rwrife/pinpath/hardware/README.md

# Hardware plan

## System block description

```text
USB 5 V SELV
    |
[power/protection] -> [RP2040 module + USB CDC]
                            |
                  [protected scan front end]
                     /                \
             [16-pin Bank A]      [16-pin Bank B]
                     |                  |
              passive adapter     passive adapter
                       \              /
                    de-energized cable
```

The rev-A schematic uses Raspberry Pi Pico `SC0915`, eight TI `TMUX1108PWR` muxes for independent stimulus/sense paths, 10 kΩ endpoint current limiting, low-leakage rail clamps, four-channel ESD arrays, and a two-phase 0/1.8 V precheck bias. The editable project is now in `pinpath.kicad_pro` / `pinpath.kicad_sch`; exact references, packages, manufacturer properties, GPIO allocation, and pinout evidence are in [the component-selection handoff](selection/component-selection.md) and [schematic pinout evidence](schematic-pinout-evidence.md). Native KiCad 9 ERC is clean, but this remains static EDA evidence only: `selection/limits-rev-a.json` is still `validated: false`, so no scan is authorized before layout review and bench characterization. Normative behavior and evidence gates remain in [requirements](requirements.md), [architecture](../docs/architecture.md), [risk analysis](../docs/risk-analysis.md), and the [verification matrix](../docs/verification-matrix.md).

## Interfaces

- USB CDC for power, configuration, and reports
- Two keyed 16-position low-voltage test-bank connectors
- Replaceable passive adapters; first targets are numbered headers and labeled flying leads
- SWD or vendor-supported debug connection and a documented recovery path
- Physical start/cancel control and text/shape-capable or coded status indication

## Power plan

USB 5 V SELV enters only through the Pico micro-USB connector; its on-module supply generates 3V3 for the candidate front end. The two-phase precheck requires all 32 endpoints to track both a low bias and the measured 1.8 V reference while every stimulus enable is low. Provisional thresholds and calculated fault currents are recorded in `selection/limits-rev-a.json`, but are explicitly unvalidated and cannot authorize firmware scanning. The design must not source meaningful operating power into the item under test.

## Enclosure and assembly concept

A small screw-fastened or snap-fit printed enclosure will expose the two adapter sockets, USB, button, and status window. The PCB will use hand-assembly-friendly parts where practical, mounting holes, clear pin numbering, probeable test points, and replaceable adapters so connector wear does not require replacing the main board.

## Safety limits

Use only with fully disconnected, de-energized passive cables and harnesses. Never attach mains, PoE, powered USB through a test bank, a battery or battery pack, vehicles, medical or life-safety wiring, or any energized circuit. PinPath makes no cable certification claim and is not a hipot tester, insulation tester, precision ohmmeter, or protective instrument. Protection circuitry cannot make prohibited live testing safe.

## Editable KiCad deliverables

Current schematic-stage sources and evidence are:

- `hardware/pinpath.kicad_pro`
- `hardware/pinpath.kicad_sch`
- `hardware/pinpath.kicad_pcb` (rev-A carrier layout candidate; see [PCB layout evidence](PCB-layout-evidence.md) for DRC status, residuals, and fab-candidate posture)
- `hardware/pinpath.kicad_sym`
- `hardware/pinpath.pretty/RaspberryPi_Pico_SMD_HandSolder.kicad_mod`
- `hardware/TestPoint.pretty/` (project-local micro test points)
- `hardware/schematic-pinout-evidence.md`
- `hardware/PCB-layout-evidence.md`
- `hardware/reports/pinpath-erc.rpt`
- `hardware/reports/drc-20260918-final.json` (0 errors; adjudicated warnings)
- `hardware/reports/pinpath-schematic.pdf` (review supplement, not source)
- `hardware/fab-out/pinpath-gerbers/` + `fab-out/gerber-inspection.json` (inspected release-candidate fabrication outputs)
- `hardware/adapters/known-loopback/` (passive one-to-one electrical fixture definition)
- `bom/bom.csv` (native export from schematic properties)
- `bom/non-schematic-items.csv`

The carrier PCB now exists as a layout candidate with 0-error native DRC;
the single remaining stub, pour-island residual, and adapter cable-assembly
decision are adjudicated in [PCB layout evidence](PCB-layout-evidence.md).
Final Manufacturer/MPN/source data lives in schematic symbol properties and
exports to tracked `bom/bom.csv`; volatile costs remain explicitly `UNKNOWN`
until dated supplier evidence is obtained.

## Issue #7 integration artifacts (2026-09-19)

- `reports/erc-20260919-release.rpt` — native ERC re-run on committed
  schematic: 0 errors / 0 warnings.
- `reports/drc-20260919-release.json` — native DRC re-run including
  schematic-parity: 0 errors, 63 warnings, 66 ratsnest items — identical to
  the 2026-09-18 candidate state; the 4 parity entries are the off-schematic
  mounting holes (intentional, see layout evidence item 4).
- `reports/pinpath-schematic-20260919-release.pdf` — review PDF re-export.
- `reports/integration-scenario-matrix-hostsim.json` — 13-scenario
  integration matrix executed by `firmware/tests/test_scenarios.cpp`;
  `host_simulation` evidence only, not bench evidence.
- `fab-out/renders/` — native `kicad-cli pcb render` top/bottom renders of
  the unpopulated candidate.
- Assembly guide, bring-up checklist, and characterization plan live in
  `../docs/`; the release gate is `../release/RELEASE-READINESS.md`.
