rwrife/pinpath/release/RELEASE-READINESS.md

# PinPath rev-A candidate — release readiness checklist and manifest status

Status: **release NOT tagged and MUST NOT be tagged yet.** This issue's own
acceptance line — "tag a release only when evidence supports it" — is not met,
because the bench evidence gate is open: no unit has been fabricated or
assembled, `hardware/selection/limits-rev-a.json` is `validated: false`, and
firmware scanning remains unauthorized. What follows is the reproducible
manifest of what the repository *does* contain today, plus the explicit gap
list that gates a real `v0.x` tag.

## Gate status

| Gate | State | Evidence / blocker |
|---|---|---|
| Editable KiCad sources (carrier + adapter) | ✅ present | `hardware/pinpath.kicad_*`, `hardware/adapters/known-loopback/` |
| Native ERC | ✅ 0 errors / 0 warnings | `hardware/reports/erc-20260919-release.rpt` (KiCad 9.0.9) |
| Native DRC | ⚠️ 0 errors, 63 warnings | `hardware/reports/drc-20260919-release.json`; documented exceptions + `U9.2` fanout stub in `hardware/PCB-layout-evidence.md` — board is NOT fab-ready until the stub resolves (rev-B decision) |
| Schematic PDF | ✅ regenerated 2026-09-19 | `hardware/reports/pinpath-schematic-20260919-release.pdf` |
| Gerbers/drills/CPL inspected | ⚠️ inspected, geometry current | `hardware/fab-out/` + `fab-out/gerber-inspection.json`; re-exported 2026-09-19, bodies byte-identical to inspected archive (timestamp lines differ only) |
| BOM from schematic properties | ✅ | `bom/bom.csv` re-export byte-identical 2026-09-19; cost cells deliberately `UNKNOWN` |
| Firmware builds + host tests | ✅ green | `firmware` CI (host tests + RP2040 UF2); 13-scenario integration matrix `hardware/reports/integration-scenario-matrix-hostsim.json` |
| App lint/tests/a11y/build | ✅ green | app CI: lint, 18 unit tests, a11y, web build, unsigned Tauri package |
| Integration scenario matrix (host sim) | ✅ 13/13 pass | `firmware/tests/test_scenarios.cpp`; SIM-class only |
| Bench characterization (M1–M5) | ❌ **not executed — no hardware** | `docs/characterization-plan.md`, `docs/bring-up-checklist.md` |
| Limits validated / scan authorized | ❌ by design | `limits-rev-a.json` `validated: false` |
| Assembly/bring-up docs | ✅ written, placeholders marked | `docs/assembly-guide.md`, `docs/bring-up-checklist.md` |
| Licenses + third-party attribution | ✅ | MIT `LICENSE`, `THIRD_PARTY_NOTICES.md` |
| Tagged release | ❌ blocked by bench gate | this document |

## Reproducible manifest of the rev-A candidate snapshot (2026-09-19)

Checksums are SHA-256 over the committed files (see `manifest-checksums.txt`
next to this file for the authoritative list, regenerated by
`release/generate_checksums.sh`).

| Artifact class | Paths | Notes |
|---|---|---|
| Editable hardware sources | `hardware/pinpath.kicad_{pro,sch,pcb,sym}`, `hardware/pinpath.pretty/`, `hardware/TestPoint.pretty/`, `hardware/adapters/known-loopback/*` | KiCad 9 |
| Normative docs | `hardware/requirements.md`, `docs/architecture.md`, `docs/protocol.md`, `docs/risk-analysis.md`, `docs/verification-matrix.md` | issue #1 baseline |
| Selection + limits | `hardware/selection/*` | `validated: false` gates scanning |
| ERC/DRC/net evidence | `hardware/reports/` | includes 2026-09-19 release set + host-sim matrix |
| Fabrication outputs | `hardware/fab-out/pinpath-gerbers/`, `pinpath-cpl.csv`, `gerber-inspection.json` | release candidates, not fab-accepted |
| Board renders | `hardware/fab-out/renders/` | 3-D renders of the unpopulated candidate (real tool output) |
| BOM | `bom/bom.csv`, `bom/non-schematic-items.csv` | schematic-property source of truth |
| Firmware | `firmware/`, pinned SDK submodule | Pico SDK 2.0.0 `efe2103…` |
| App | `app/` | Tauri 2 / React / SQLite |
| Assembly & bring-up | `docs/assembly-guide.md`, `docs/bring-up-checklist.md`, `docs/characterization-plan.md` | placeholders explicit |

## Photo/render placeholders (real media pending)

- Populated-board photos (top/bottom) — pending an actual assembly.
- J1/J2 cavity-numbering overlay diagram — pending fab-drawing review.
- J3↔SC0889 debug cable pinout — pending cable selection.
- Flying-lead adapter build photos — pending the first build.
Until these exist, the assembly guide marks each with `[PHOTO/DIAGRAM
PLACEHOLDER]`; the two 3-D PNG renders are genuine KiCad output but show the
**unpopulated** board only.

## Path to a tag (ordered)

1. Resolve the `U9.2` fanout stub (rev-B rule/pad decision) → DRC 0 errors
   with the stub closed, or accept documented rev-A posture explicitly at a
   fab DFM review.
2. Order boards; inspect received panels against `fab-out/` records.
3. Assemble per `docs/assembly-guide.md`.
4. Execute `docs/bring-up-checklist.md` steps 0–4 with recorded instruments.
5. Execute `docs/characterization-plan.md` M1–M5; update `limits-rev-a.json`
   to validated with new revision.
6. Re-run ERC/DRC/analyzers, firmware and app gates; refresh BOM dates.
7. Only then cut a tag and a release archive with checksums; the app packages
   remain unsigned development artifacts with checksums (signing/notarization
   is a separate later milestone).
