rwrife/pinpath/hardware/fab-out/renders/pinpath-bottom-20260919.png

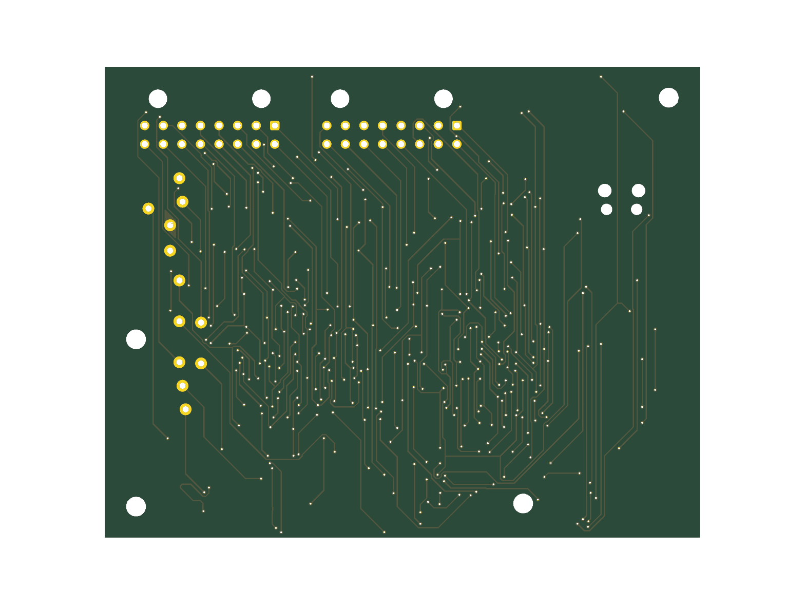
hardware/fab-out/renders/pinpath-bottom-20260919.png
