rwrife/pinpath/hardware/fab-out/renders/pinpath-top-20260919.png

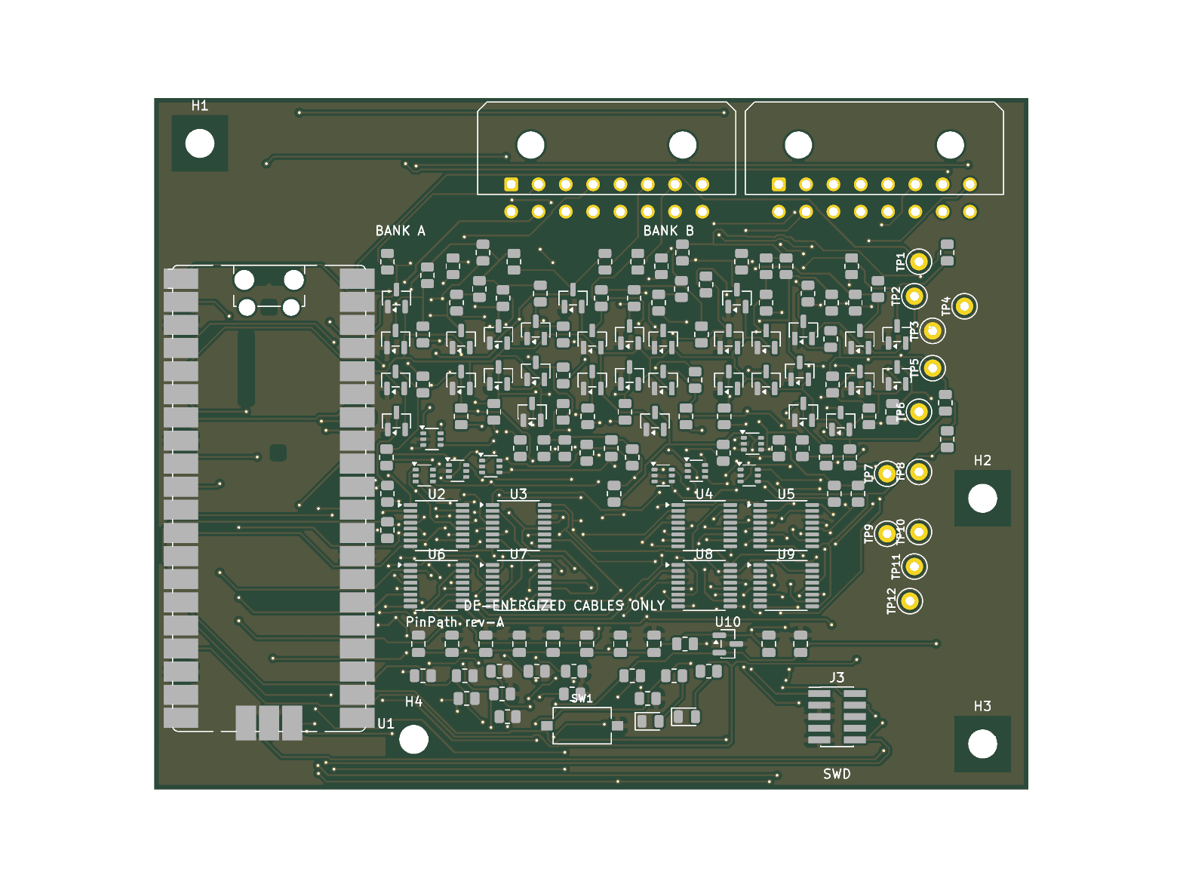
hardware/fab-out/renders/pinpath-top-20260919.png
