rwrife/pinpath/hardware/reports/pinpath-schematic-20260919-release.pdf

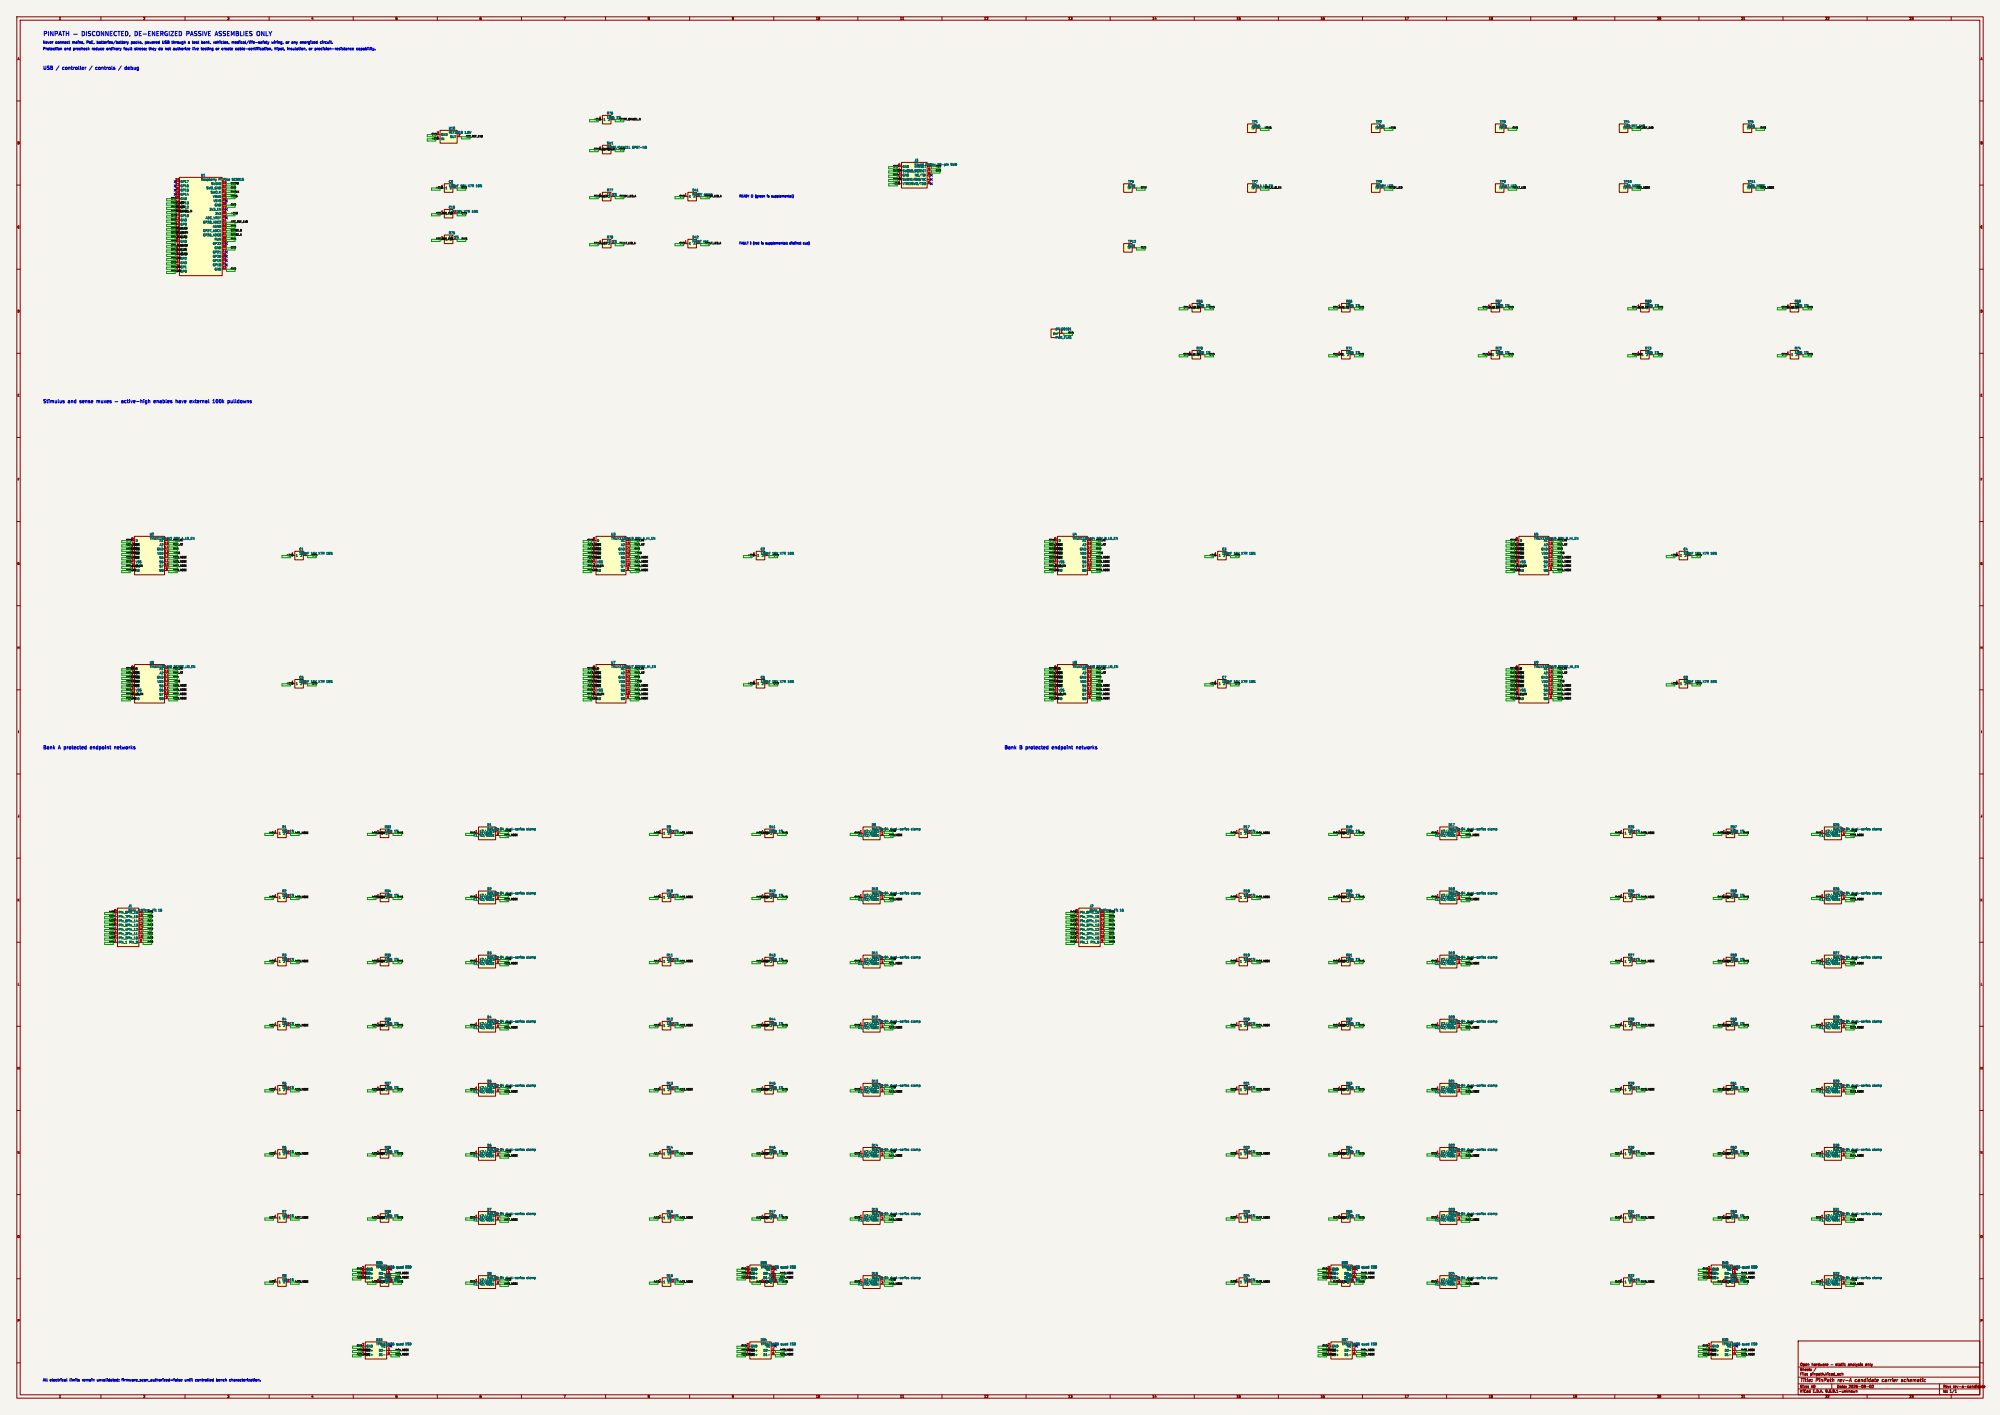
[picture p3: page 1]

USB / controller / controls / debug

nRESET
9 NC/TDI 8 KEY/NC

3V3 36 ADC_VREF 35 GP28_ADC2 34 AGND 33 GP27_ADC1 32 GP26_ADC0 31 RUN 30 GP22 29 GND 28 GP21 27 GP20 26 GP19 25 GP18 24 GND 23 U1 Raspberry Pi Pico SC0915

Bank A protected endpoint networks

Bank B protected endpoint networks

Id: 1/1 Title: PinPath rev-A candidate carrier schematic
