rwrife/pinpath/hardware/adapters/known-loopback/known-loopback-schematic.pdf

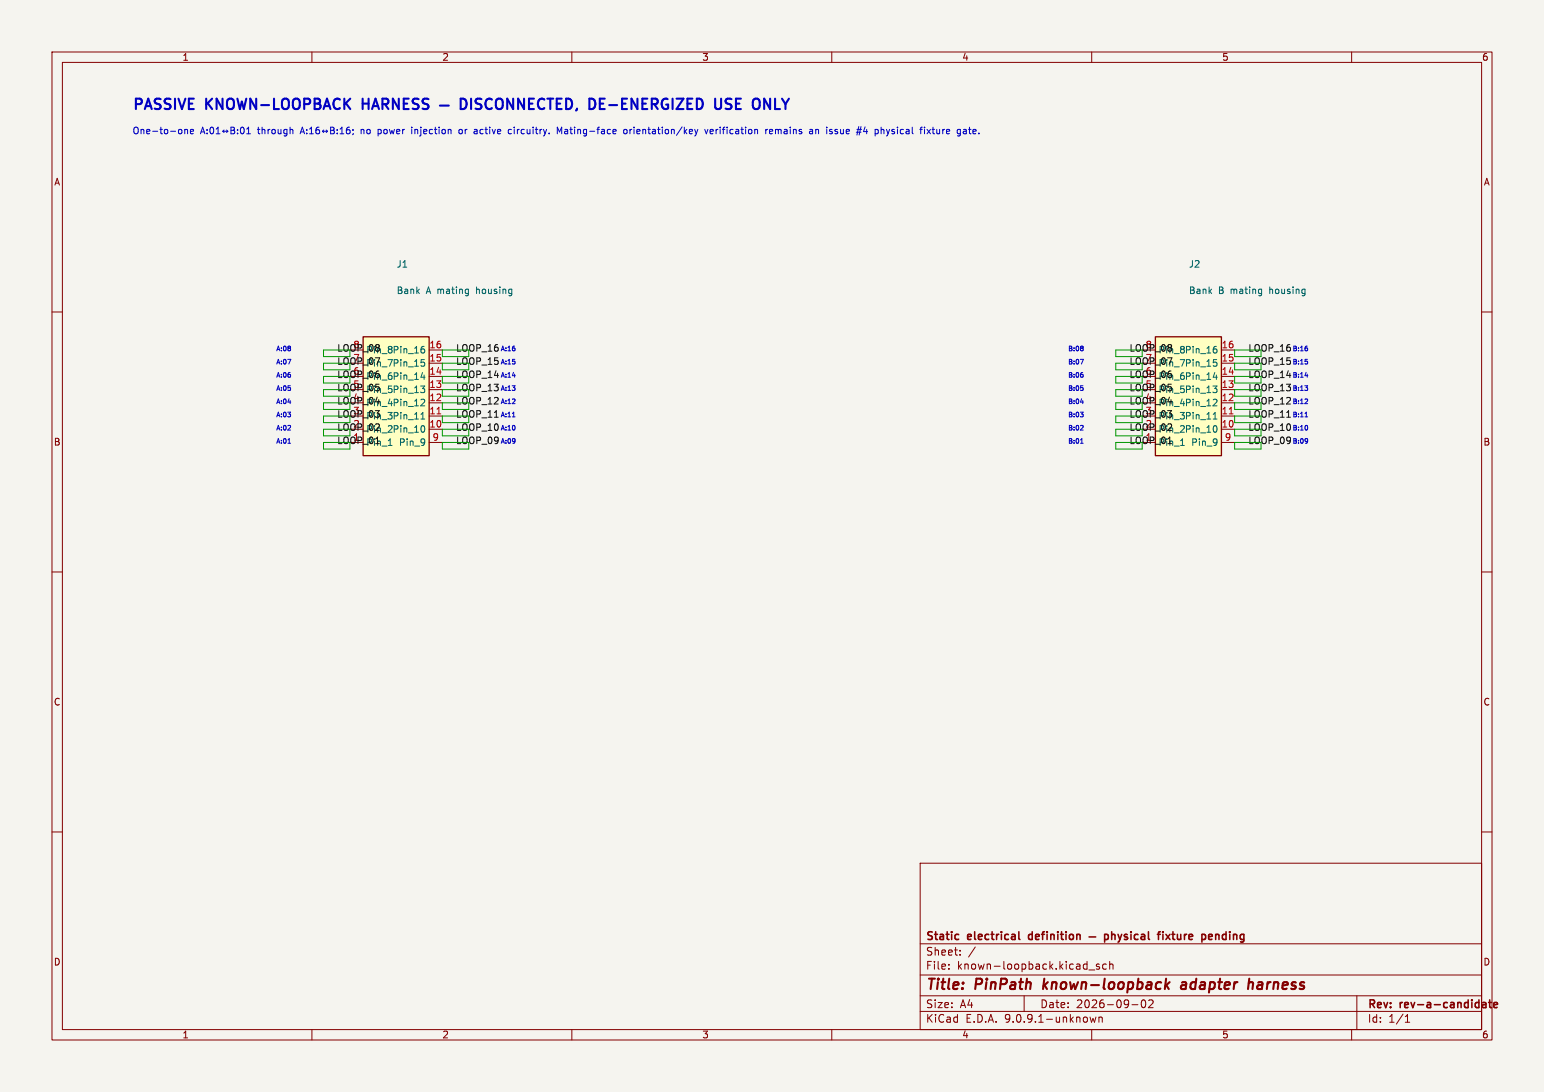
[picture p4: page 1]
