rwrife/pinpath/(list of files, drawings)

Other design files:
hardware/router/pp17-pass1.dsn
hardware/router/pp17-pass2.dsn
