rwrife/pinpath/hardware/pinpath.kicad_pcb

## KiCad design hardware/pinpath.kicad_pcb (2026-09-18)

Schematic: pinpath.kicad_sch, PinPath rev-A candidate carrier schematic

Parts:
C1, C2, C3, C4, C5, C6, C7, C8, C9: 100nF 16V X7R 10%; C_0805_2012Metric; MPN GRM21BR71C104KA01L
C10: 1uF 16V X7R 10%; C_0805_2012Metric; MPN GRM21BR71C105KA01L
D1, D2, D3, D4, D5, D6, D7, D8, D9, D10, D11, D12, D13, D14, D15, D16, D17, D18, D19, D20, D21, D22, D23, D24, D25, D26, D27, D28, D29, D30, D31, D32: BAS70-04 dual-series clamp; SOT-23; MPN BAS70-04,215
D33, D34, D35, D36, D37, D38, D39, D40: TPD4E1U06 quad ESD; SOT-363_SC-70-6; MPN TPD4E1U06DCKR
D41: READY green; LED_0805_2012Metric; MPN APT2012LZGCK
D42: FAULT red; LED_0805_2012Metric; MPN APTD2012LSURCK
J1: Bank A Micro-Fit 16; Molex_Micro-Fit_3.0_43045-1600_2x08_P3.00mm_Horizontal; MPN 43045-1600
J2: Bank B Micro-Fit 16; Molex_Micro-Fit_3.0_43045-1600_2x08_P3.00mm_Horizontal; MPN 43045-1600
J3: Keyed Cortex 10-pin SWD; PinHeader_2x05_P1.27mm_Vertical_SMD; MPN FTSH-105-01-L-DV-K
R1, R2, R3, R4, R5, R6, R7, R8, R9, R10, R11, R12, R13, R14, R15, R16, R17, R18, R19, R20, R21, R22, R23, R24, R25, R26, R27, R28, R29, R30, R31, R32: 10k 1%; R_0805_2012Metric; MPN CRCW080510K0FKEA
R33, R34, R35, R36, R37, R38, R39, R40, R41, R42, R43, R44, R45, R46, R47, R48, R49, R50, R51, R52, R53, R54, R55, R56, R57, R58, R59, R60, R61, R62, R63, R64, R65, R66, R67, R68, R69, R70, R71, R72, R73, R74, R76: 100k 1%; R_0805_2012Metric; MPN CRCW0805100KFKEA
R75, R77, R78: 1k 1%; R_0805_2012Metric; MPN CRCW08051K00FKEA
SW1: START/CANCEL SPST-NO; SW_Tactile_SPST_NO_Straight_CK_PTS636Sx25SMTRLFS; MPN PTS636SK25FSMTRLFS
TP1: VBUS; TestPoint_Keystone_5015_Micro-Minature; MPN 5015
TP2: +3V3; TestPoint_Keystone_5015_Micro-Minature; MPN 5015
TP3: GND; TestPoint_Keystone_5015_Micro-Minature; MPN 5015
TP4: ADC_REF_1V8; TestPoint_Keystone_5015_Micro-Minature; MPN 5015
TP5: BIAS; TestPoint_Keystone_5015_Micro-Minature; MPN 5015
TP6: STIM; TestPoint_Keystone_5015_Micro-Minature; MPN 5015
TP7: DRV_A_LO_EN; TestPoint_Keystone_5015_Micro-Minature; MPN 5015
TP8: READY_LED; TestPoint_Keystone_5015_Micro-Minature; MPN 5015
TP9: FAULT_LED; TestPoint_Keystone_5015_Micro-Minature; MPN 5015
TP10: A:01_NODE; TestPoint_Keystone_5015_Micro-Minature; MPN 5015
TP11: B:01_NODE; TestPoint_Keystone_5015_Micro-Minature; MPN 5015
TP12: RUN; TestPoint_Keystone_5015_Micro-Minature; MPN 5015
U1: Raspberry Pi Pico SC0915; RaspberryPi_Pico_SMD_HandSolder; MPN SC0915
U2: TMUX1108 U2 DRV_A_LO_EN; TSSOP-16_4.4x5mm_P0.65mm; MPN TMUX1108PWR
U3: TMUX1108 U3 DRV_A_HI_EN; TSSOP-16_4.4x5mm_P0.65mm; MPN TMUX1108PWR
U4: TMUX1108 U4 DRV_B_LO_EN; TSSOP-16_4.4x5mm_P0.65mm; MPN TMUX1108PWR
U5: TMUX1108 U5 DRV_B_HI_EN; TSSOP-16_4.4x5mm_P0.65mm; MPN TMUX1108PWR
U6: TMUX1108 U6 SENSE_LO_EN; TSSOP-16_4.4x5mm_P0.65mm; MPN TMUX1108PWR
U7: TMUX1108 U7 SENSE_HI_EN; TSSOP-16_4.4x5mm_P0.65mm; MPN TMUX1108PWR
U8: TMUX1108 U8 SENSE_LO_EN; TSSOP-16_4.4x5mm_P0.65mm; MPN TMUX1108PWR
U9: TMUX1108 U9 SENSE_HI_EN; TSSOP-16_4.4x5mm_P0.65mm; MPN TMUX1108PWR
U10: REF3318 1.8V; SOT-23; MPN REF3318AIDBZR

Connections:
/+3V3: C1.1, C2.1, C3.1, C4.1, C5.1, C6.1, C7.1, C8.1, C9.1, D1.2 (K2/+3V3), D2.2 (K2/+3V3), D3.2 (K2/+3V3), D4.2 (K2/+3V3), D5.2 (K2/+3V3), D6.2 (K2/+3V3), D7.2 (K2/+3V3), D8.2 (K2/+3V3), D9.2 (K2/+3V3), D10.2 (K2/+3V3), D11.2 (K2/+3V3), D12.2 (K2/+3V3), D13.2 (K2/+3V3), D14.2 (K2/+3V3), D15.2 (K2/+3V3), D16.2 (K2/+3V3), D17.2 (K2/+3V3), D18.2 (K2/+3V3), D19.2 (K2/+3V3), D20.2 (K2/+3V3), D21.2 (K2/+3V3), D22.2 (K2/+3V3), D23.2 (K2/+3V3), D24.2 (K2/+3V3), D25.2 (K2/+3V3), D26.2 (K2/+3V3), D27.2 (K2/+3V3), D28.2 (K2/+3V3), D29.2 (K2/+3V3), D30.2 (K2/+3V3), D31.2 (K2/+3V3), D32.2 (K2/+3V3), J3.1 (VTREF), R76.1, TP2.1, U1.36 (3V3), U2.13 (VDD), U3.13 (VDD), U4.13 (VDD), U5.13 (VDD), U6.13 (VDD), U7.13 (VDD), U8.13 (VDD), U9.13 (VDD), U10.1 (IN)
/A:01: J1.1, R1.1
/A:01_NODE: D1.3 (K1/A2/NODE), D33.1 (D1+), R1.2, R33.1, TP10.1, U2.4 (S1), U6.4 (S1)
/A:02: J1.2, R2.1
/A:02_NODE: D2.3 (K1/A2/NODE), D33.6 (D1-), R2.2, R34.1, U2.5 (S2), U6.5 (S2)
/A:03: J1.3, R3.1
/A:03_NODE: D3.3 (K1/A2/NODE), D33.3 (D2+), R3.2, R35.1, U2.6 (S3), U6.6 (S3)
/A:04: J1.4, R4.1
/A:04_NODE: D4.3 (K1/A2/NODE), D33.4 (D2-), R4.2, R36.1, U2.7 (S4), U6.7 (S4)
/A:05: J1.5, R5.1
/A:05_NODE: D5.3 (K1/A2/NODE), D34.1 (D1+), R5.2, R37.1, U2.12 (S5), U6.12 (S5)
/A:06: J1.6, R6.1
/A:06_NODE: D6.3 (K1/A2/NODE), D34.6 (D1-), R6.2, R38.1, U2.11 (S6), U6.11 (S6)
/A:07: J1.7, R7.1
/A:07_NODE: D7.3 (K1/A2/NODE), D34.3 (D2+), R7.2, R39.1, U2.10 (S7), U6.10 (S7)
/A:08: J1.8, R8.1
/A:08_NODE: D8.3 (K1/A2/NODE), D34.4 (D2-), R8.2, R40.1, U2.9 (S8), U6.9 (S8)
/A:09: J1.9, R9.1
/A:09_NODE: D9.3 (K1/A2/NODE), D35.1 (D1+), R9.2, R41.1, U3.4 (S1), U7.4 (S1)
/A:10: J1.10, R10.1
/A:10_NODE: D10.3 (K1/A2/NODE), D35.6 (D1-), R10.2, R42.1, U3.5 (S2), U7.5 (S2)
/A:11: J1.11, R11.1
/A:11_NODE: D11.3 (K1/A2/NODE), D35.3 (D2+), R11.2, R43.1, U3.6 (S3), U7.6 (S3)
/A:12: J1.12, R12.1
/A:12_NODE: D12.3 (K1/A2/NODE), D35.4 (D2-), R12.2, R44.1, U3.7 (S4), U7.7 (S4)
/A:13: J1.13, R13.1
/A:13_NODE: D13.3 (K1/A2/NODE), D36.1 (D1+), R13.2, R45.1, U3.12 (S5), U7.12 (S5)
/A:14: J1.14, R14.1
/A:14_NODE: D14.3 (K1/A2/NODE), D36.6 (D1-), R14.2, R46.1, U3.11 (S6), U7.11 (S6)
/A:15: J1.15, R15.1
/A:15_NODE: D15.3 (K1/A2/NODE), D36.3 (D2+), R15.2, R47.1, U3.10 (S7), U7.10 (S7)
/A:16: J1.16, R16.1
/A:16_NODE: D16.3 (K1/A2/NODE), D36.4 (D2-), R16.2, R48.1, U3.9 (S8), U7.9 (S8)
/ADC_REF_1V8: C10.1, R75.1, TP4.1, U1.34 (GP28_ADC2), U10.2 (OUT)
/B:01: J2.1, R17.1
/B:01_NODE: D17.3 (K1/A2/NODE), D37.1 (D1+), R17.2, R49.1, TP11.1, U4.4 (S1), U8.4 (S1)
/B:02: J2.2, R18.1
/B:02_NODE: D18.3 (K1/A2/NODE), D37.6 (D1-), R18.2, R50.1, U4.5 (S2), U8.5 (S2)
/B:03: J2.3, R19.1
/B:03_NODE: D19.3 (K1/A2/NODE), D37.3 (D2+), R19.2, R51.1, U4.6 (S3), U8.6 (S3)
/B:04: J2.4, R20.1
/B:04_NODE: D20.3 (K1/A2/NODE), D37.4 (D2-), R20.2, R52.1, U4.7 (S4), U8.7 (S4)
/B:05: J2.5, R21.1
/B:05_NODE: D21.3 (K1/A2/NODE), D38.1 (D1+), R21.2, R53.1, U4.12 (S5), U8.12 (S5)
/B:06: J2.6, R22.1
/B:06_NODE: D22.3 (K1/A2/NODE), D38.6 (D1-), R22.2, R54.1, U4.11 (S6), U8.11 (S6)
/B:07: J2.7, R23.1
/B:07_NODE: D23.3 (K1/A2/NODE), D38.3 (D2+), R23.2, R55.1, U4.10 (S7), U8.10 (S7)
/B:08: J2.8, R24.1
/B:08_NODE: D24.3 (K1/A2/NODE), D38.4 (D2-), R24.2, R56.1, U4.9 (S8), U8.9 (S8)
/B:09: J2.9, R25.1
/B:09_NODE: D25.3 (K1/A2/NODE), D39.1 (D1+), R25.2, R57.1, U5.4 (S1), U9.4 (S1)
/B:10: J2.10, R26.1
/B:10_NODE: D26.3 (K1/A2/NODE), D39.6 (D1-), R26.2, R58.1, U5.5 (S2), U9.5 (S2)
/B:11: J2.11, R27.1
/B:11_NODE: D27.3 (K1/A2/NODE), D39.3 (D2+), R27.2, R59.1, U5.6 (S3), U9.6 (S3)
/B:12: J2.12, R28.1
/B:12_NODE: D28.3 (K1/A2/NODE), D39.4 (D2-), R28.2, R60.1, U5.7 (S4), U9.7 (S4)
/B:13: J2.13, R29.1
/B:13_NODE: D29.3 (K1/A2/NODE), D40.1 (D1+), R29.2, R61.1, U5.12 (S5), U9.12 (S5)
/B:14: J2.14, R30.1
/B:14_NODE: D30.3 (K1/A2/NODE), D40.6 (D1-), R30.2, R62.1, U5.11 (S6), U9.11 (S6)
/B:15: J2.15, R31.1
/B:15_NODE: D31.3 (K1/A2/NODE), D40.3 (D2+), R31.2, R63.1, U5.10 (S7), U9.10 (S7)
/B:16: J2.16, R32.1
/B:16_NODE: D32.3 (K1/A2/NODE), D40.4 (D2-), R32.2, R64.1, U5.9 (S8), U9.9 (S8)
/BIAS: R33.2, R34.2, R35.2, R36.2, R37.2, R38.2, R39.2, R40.2, R41.2, R42.2, R43.2, R44.2, R45.2, R46.2, R47.2, R48.2, R49.2, R50.2, R51.2, R52.2, R53.2, R54.2, R55.2, R56.2, R57.2, R58.2, R59.2, R60.2, R61.2, R62.2, R63.2, R64.2, R75.2, TP5.1, U1.14 (GP10)
/DRV_A_HI_EN: R66.1, U1.6 (GP4), U3.2 (EN)
/DRV_A_LO_EN: R65.1, TP7.1, U1.5 (GP3), U2.2 (EN)
/DRV_B_HI_EN: R68.1, U1.9 (GP6), U5.2 (EN)
/DRV_B_LO_EN: R67.1, U1.7 (GP5), U4.2 (EN)
/FAULT_LED: R78.1, TP9.1, U1.17 (GP13)
/FAULT_LED_A: D42.2 (A), R78.2
/GND: C1.2, C2.2, C3.2, C4.2, C5.2, C6.2, C7.2, C8.2, C9.2, C10.2, D1.1 (A1/GND), D2.1 (A1/GND), D3.1 (A1/GND), D4.1 (A1/GND), D5.1 (A1/GND), D6.1 (A1/GND), D7.1 (A1/GND), D8.1 (A1/GND), D9.1 (A1/GND), D10.1 (A1/GND), D11.1 (A1/GND), D12.1 (A1/GND), D13.1 (A1/GND), D14.1 (A1/GND), D15.1 (A1/GND), D16.1 (A1/GND), D17.1 (A1/GND), D18.1 (A1/GND), D19.1 (A1/GND), D20.1 (A1/GND), D21.1 (A1/GND), D22.1 (A1/GND), D23.1 (A1/GND), D24.1 (A1/GND), D25.1 (A1/GND), D26.1 (A1/GND), D27.1 (A1/GND), D28.1 (A1/GND), D29.1 (A1/GND), D30.1 (A1/GND), D31.1 (A1/GND), D32.1 (A1/GND), D33.2 (GND), D34.2 (GND), D35.2 (GND), D36.2 (GND), D37.2 (GND), D38.2 (GND), D39.2 (GND), D40.2 (GND), D41.1 (K), D42.1 (K), J3.3 (GND), J3.5 (GND), J3.9 (GND_DETECT), R65.2, R66.2, R67.2, R68.2, R69.2, R70.2, R71.2, R72.2, R73.2, R74.2, SW1.2, TP3.1, U1.3 (GND), U1.8 (GND), U1.13 (GND), U1.18 (GND), U1.23 (GND), U1.28 (GND), U1.33 (AGND), U1.38 (GND), U1.D2 (SWD_GND), U2.3 (VSS), U2.14 (GND), U3.3 (VSS), U3.14 (GND), U4.3 (VSS), U4.14 (GND), U5.3 (VSS), U5.14 (GND), U6.3 (VSS), U6.14 (GND), U7.3 (VSS), U7.14 (GND), U8.3 (VSS), U8.14 (GND), U9.3 (VSS), U9.14 (GND), U10.3 (GND)
/MUX_A0: R71.1, U1.1 (GP0), U2.1 (A0), U3.1 (A0), U4.1 (A0), U5.1 (A0), U6.1 (A0), U7.1 (A0), U8.1 (A0), U9.1 (A0)
/MUX_A1: R72.1, U1.2 (GP1), U2.16 (A1), U3.16 (A1), U4.16 (A1), U5.16 (A1), U6.16 (A1), U7.16 (A1), U8.16 (A1), U9.16 (A1)
/MUX_A2: R73.1, U1.4 (GP2), U2.15 (A2), U3.15 (A2), U4.15 (A2), U5.15 (A2), U6.15 (A2), U7.15 (A2), U8.15 (A2), U9.15 (A2)
/READY_LED: R77.1, TP8.1, U1.16 (GP12)
/READY_LED_A: D41.2 (A), R77.2
/RUN: J3.10 (nRESET), TP12.1, U1.30 (RUN)
/SENSE_A: U1.31 (GP26_ADC0), U6.8 (D), U7.8 (D)
/SENSE_B: U1.32 (GP27_ADC1), U8.8 (D), U9.8 (D)
/SENSE_HI_EN: R70.1, U1.11 (GP8), U7.2 (EN), U9.2 (EN)
/SENSE_LO_EN: R69.1, U1.10 (GP7), U6.2 (EN), U8.2 (EN)
/START_CANCEL_N: R76.2, SW1.1, U1.15 (GP11)
/STIM: R74.1, TP6.1, U1.12 (GP9), U2.8 (D), U3.8 (D), U4.8 (D), U5.8 (D)
/SWCLK: J3.4 (SWCLK/TCK), U1.D1 (SWCLK)
/SWDIO: J3.2 (SWDIO/TMS), U1.D3 (SWDIO)
/VBUS: TP1.1, U1.40 (VBUS)

Notes on the sheet:
PINPATH — DISCONNECTED, DE-ENERGIZED PASSIVE ASSEMBLIES ONLY
Never connect mains, PoE, batteries/battery packs, powered USB through a test bank, vehicles, medical/life-safety wiring, or any energized circuit.
Protection and precheck reduce ordinary fault stress; they do not authorize live testing or create cable-certification, hipot, insulation, or precision-resistance capability.
USB / controller / controls / debug
Stimulus and sense muxes — active-high enables have external 100k pulldowns
Bank A protected endpoint networks
Bank B protected endpoint networks
All electrical limits remain unvalidated; firmware_scan_authorized=false until controlled bench characterization.
READY ✓ (green is supplemental)
FAULT ! (red is supplemental; distinct cue)

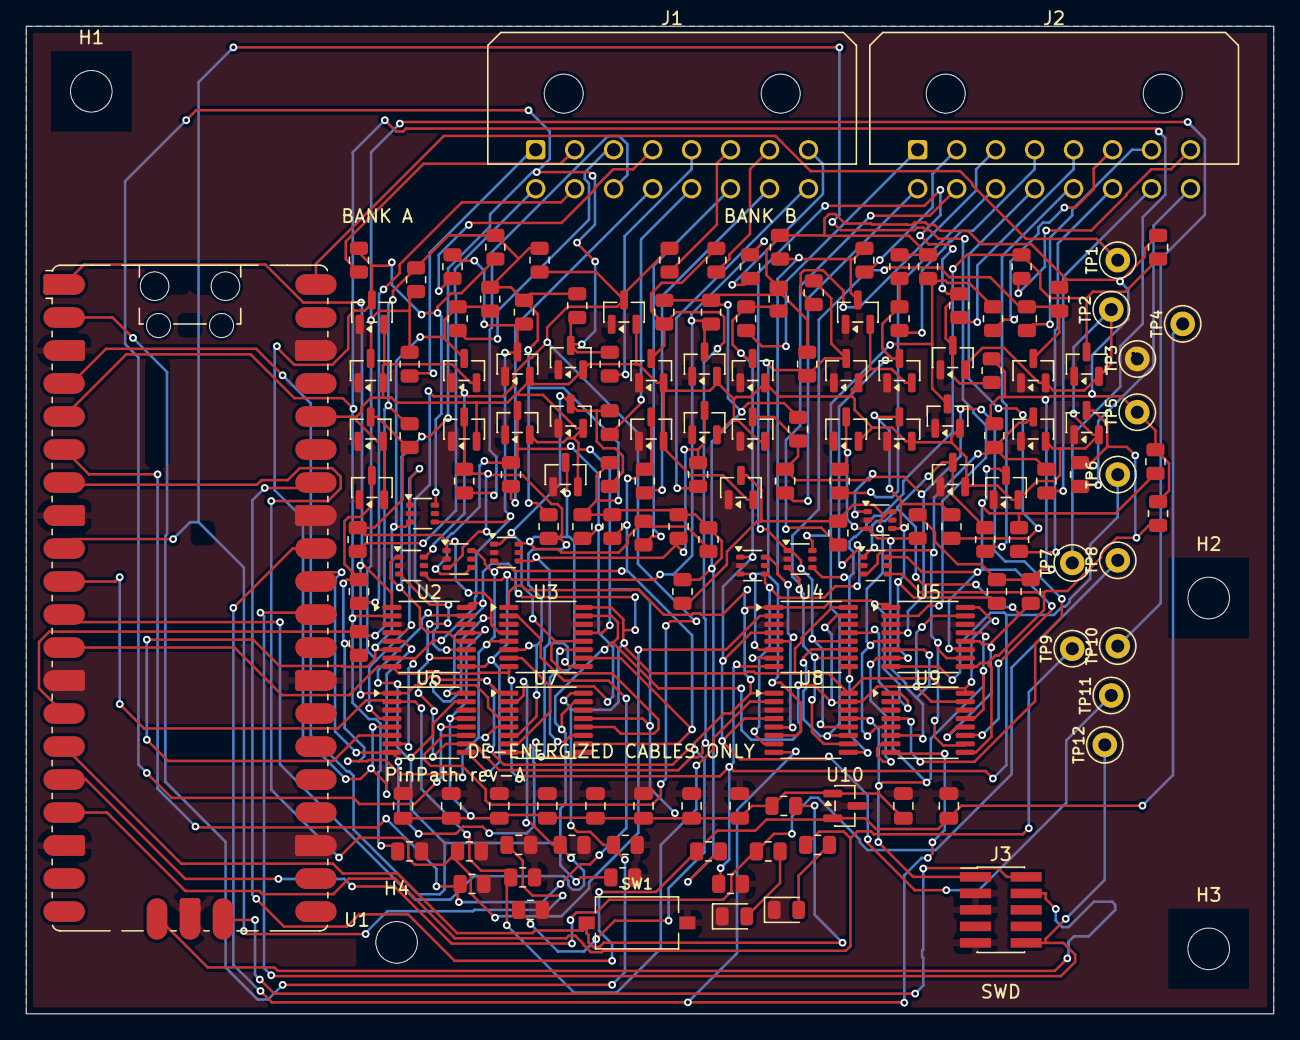
[picture p5: board pinpath.kicad_pcb from above]

Board: 2 copper layers, 96.0 x 76.0 mm, 160 parts (0 on the bottom side), 89 nets.

Other parts of the board:
H1, H2, H3, H4: MountingHole_3.2mm_M3
