rwrife/pinpath/(commit log)

2026-08-30 docs: scaffold PinPath hardware project
    [preliminary-bom.csv]
2026-09-01 feat(hardware): select rev-a candidate components (#9)
    Add manufacturer-backed parts, a machine-readable KiCad handoff, unvalidated limits, dated availability evidence, and dependency-free front-end calculations with tests.\n\nVerified by independent review and repository checks; no physical validation is claimed.
    [availability-2026-09-01.csv, preliminary-bom.csv]
2026-09-05 feat(hardware): add editable KiCad schematic, ERC reports, and tracked BOM (#10)
    Create the PinPath carrier KiCad project/schematic with verified symbol properties,
    custom footprint library entries, known-loopback adapter schematic, tracked
    sourcing BOM exports, and repeatable schematic verification tooling.
    Closes #3
    [bom.csv, known-loopback.kicad_sch, non-schematic-items.csv, pinpath.kicad_sch]
2026-09-07 fix(firmware): import pico sdk before project for toolchain detection
2026-09-07 fix(ci): install C++ ARM toolchain for rp2040 build
2026-09-07 fix(ci): use ubuntu24 arm-none-eabi stdc++ package set
2026-09-08 feat(app): build accessible offline desktop companion baseline (#12)
    * feat(app): scaffold tauri companion with offline scan workflow
    * fix(app): add tauri icon asset for unsigned packaging
    ---------
    [main.rs]
2026-09-18 feat(hardware): route rev-A carrier PCB to 0-error DRC candidate with fab inspection (#4) (#13)
    * feat(hardware): route rev-A carrier PCB to 0-error DRC candidate with fab inspection (#4)
    - pinpath.kicad_pcb: full 2-layer layout, 96x76mm closed outline, 160 footprints,
    GND pours F+B with mounting-hole keepout pockets, BANK A/B + rev + safety
    banner silk, 12 test points, M3 mounting
    - native DRC: 0 errors; ratsnest 65 pour-island pseudo pairs + 1 physics-gated
    0.65mm-TSSOP fanout stub (U9.2) adjudicated in PCB-layout-evidence.md
    - pad-to-net parity vs schematic netlist: 531/531 agreed, 30 board-only pads
    verified netless (mounting/shield/NC)
    - gerber/drill/CPL exported and inspected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
    [pinpath-B_Cu.gbl, pinpath-B_Mask.gbs, pinpath-B_Paste.gbp, pinpath-B_Silkscreen.gbo, pinpath-Edge_Cuts.gm1, pinpath-F_Cu.gtl, pinpath-F_Mask.gts, pinpath-F_Paste.gtp]
2026-09-19 feat(release): integration evidence, assembly/bring-up docs, scenario matrix (issue #7) (#14)
    - firmware: 13-scenario host-simulated integration matrix (known-good,
    open, short, multi-short, crossover, reversed-fixture, intermittent,
    cancel, reset, precheck/token lockouts, unexpected-voltage lockout,
    unvalidated-limits refusal) + archived JSON evidence record
    - docs: assembly guide (placeholders marked), bring-up checklist with
    datasheet-derived expectations and blank actuals, measurement and
    characterization plan (M1-M5) for limits validation
    - hardware: 2026-09-19 release ERC/DRC/schematic-PDF re-runs, TP net map,
    native 3-D board renders, fab archive verified geometry-current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
